chrisarevalot/Junior-Design-Project-/README.md

# Junior Design Project
# Home Secure ++
This is our Junior year design project. A home security system with appliances control, temperature gathering, and weather display. 
See Final Design Review folder for details. 

There are pictures and a video demostration of this project in the following link:
https://drive.google.com/drive/folders/1Q4WecZr4MG889WgMi7LN1pqjcStTcl-y?usp=sharing
